mendes10z/ECA_Project/ACE_Project/TRABALHO_02/RELATORIO_ACE.pdf

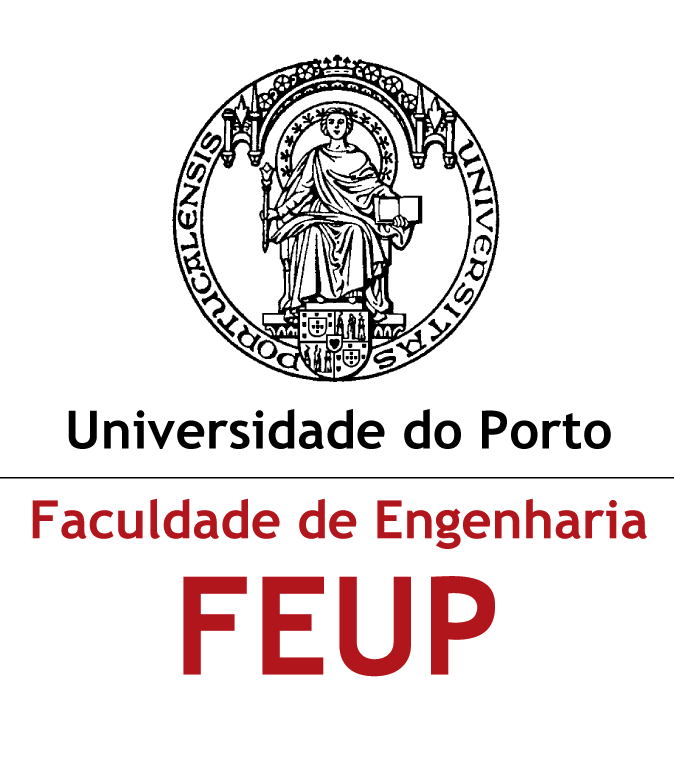
[picture p1: figure]

## "Robô Seguidor de Linha"

Rui Martins
up202104636

Ivo Mendes
up202108509

Relatório do Trabalho Prático realizado no âmbito da Unidade Curricular “Arquiteturas de Computação Embarcada”, do Mestrado em Engenharia Eletrotécnica e Computadores

Data de entrega: 30-01-2025

Declaramos que o presente trabalho/relatório é da nossa autoria e não foi utilizado previamente noutro curso ou unidade curricular, desta ou de outra instituição. As referências a outros autores (afirmações, ideias, pensamentos) respeitam escrupulosamente as regras da atribuição, e encontram-se devidamente indicadas no texto e nas referências bibliográficas, de acordo com as normas de referenciação. Temos consciência de que a prática de plágio e autoplágio constitui um ilícito académico.

In "Código Ético de Conduta Académica", art.14, Universidade do Porto.

## 1 Sumário

Este projeto envolveu o design, desenvolvimento e otimização de um robô capaz de seguir linhas e resolver labirintos (em forma de grelha) equipado com um Raspberry Pi Pico, múltiplos sensores e dois motores. Foram usadas técnicas de ajuste dinâmico de velocidade, controlo PID, calibração de sensores e mecanismos de desvio de obstáculos com o intuito de obter uma navegação mais precisa em trajetos complexos e irregulares de forma eficaz e autónoma.

## Índice

1 Sumário | 1
2 Introdução | 2
3 Hardware | 3
4 Pista | 4
5 Labirinto | 10
6 Desafios e Soluções | 18
7 Melhorias Futuras | 18
8 Conclusão | 18

## 2 Introdução

A robótica representa um dos pilares da engenharia moderna, combinando hardware e software para resolver problemas complexos. Neste contexto, o presente trabalho teve como objetivo desenvolver um robô capaz de seguir uma linha preta, de percorrer labirintos estruturados em grelha, desviar de obstáculos e ajustar dinamicamente a sua velocidade e trajetória. Utilizando um Raspberry Pi Pico como microcontrolador, o sistema integra cinco sensores infravermelhos para deteção de linha, um sensor ToF (Time-of-Flight) para evitar colisões e um controlador PID para correção de erros.
A implementação de algoritmos como o Breadth-First Search (BFS) permitiu ao robô calcular o caminho mais curto em labirintos, enquanto técnicas de otimização de hardware, como o uso de multiplexadores, garantiram alguma eficiência no processamento. Este relatório detalha não apenas as escolhas de design e os desafios técnicos enfrentados, mas também demonstra como a interação entre software e hardware foi crucial para superar limitações práticas, como atrasos de leitura de sensores e falhas inesperadas em componentes.
A abordagem adotada seguiu uma metodologia iterativa, onde cada etapa de desenvolvimento foi validada através de testes empíricos.

## 3 Hardware

### 3.1 Componentes Usados

1. Microcontrolador: Raspberry Pi Pico.
2. Motores: Dois motores DC.

### 3. Sensores:

- 5 sensores infravermelho (IR) para deteção da linha.
- Sensor de distância VL53L0X Time-of-Flight (ToF) para deteção de obstáculos.
4. Multiplexador: CD74HC4067 para expansão das entradas analógicas.
5. Driver de motor: Dual H-Bridge para controlo da direção e velocidade dos motores.
6. Fonte de Alimentação: Pack de baterias externo.

### 3.2 Design do Circuito

O hardware do robô foi conectado da seguinte forma:

- Sensores IR: Conectados ao multiplexador, que os liga a uma das entradas analógicas do Raspberry Pi Pico.
- Motores: Controlados pelo driver de motor utilizando sinais PWM.
- Sensor ToF: Comunica-se via protocolo I2C.

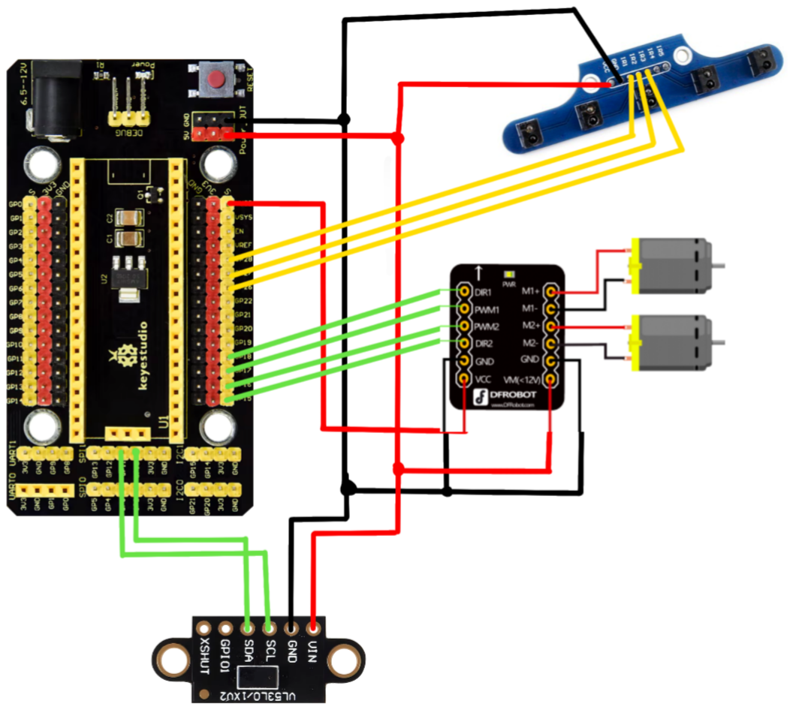
[picture p2: figure]

Figure 1: Conexões entre os componentes

## 4 Pista

### 4.1 Funcionalidades Principais

### 4.1.1 Deteção de linha

A primeira funcionalidade a merecer destaque é a deteção de linha. Como indicado no enunciado, o robô tem de ser capaz de identificar e guiar-se segundo uma linha preta num fundo branco, como ilustrado na Figura 2. Para tal, fazemos uso dos cinco sensores IR, bem como, de um método capaz de converter as leituras dos sensores em valores de erro passíveis de serem usados pelo controlador PID.

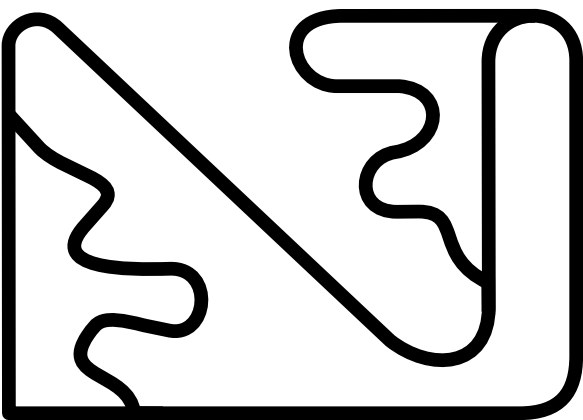
[picture p3: figure]

Figure 2: Mapa da pista.

Os sensores IR utilizados são capazes de registar valores num intervalo de 0 a 1023 e, sabendo que valores próximos de zero são zonas escuras e valores próximos de 1023 são zonas claras, somos capazes, através de um valor pré-definido de THRESHOLD, identificar quais sensores estão sobre a linha. Para além disso, o robô é capaz de recalibrar os valores máximo e mínimo de leitura registados de forma a adaptar-se a diferentes intensidade de cor de linha, por exemplo, o que permite uma normaliza mais precisa dos valores registados.

1 | void readLineSensors () {
2 | // Loop
3 | for (int i = 0; i < NUM_SENSORS ; i ++) {
4 | // Set the multiplexer to the current channel
5 | digitalWrite ( MUX_S1 , i & 0 x01 ) ; | // Bit 0
6 | digitalWrite ( MUX_S2 , ( i >> 1) & 0 x01 ) ; // Bit 1
7 | digitalWrite ( MUX_S3 , ( i >> 2) & 0 x01 ) ; // Bit 2
8 | digitalWrite ( MUX_S4 , ( i >> 3) & 0 x01 ) ; // Bit 3

9
10 | delayMicroseconds (50) ; // Allow time for the signal to stabilize

11
12 | // Read the sensor value
13 | sensorValues [ i ] = analogRead ( MUX_SIGNAL ) ;

14
15 | // Recalibrate sensor values
16 | if( sensorValues [ i ] > sensorMaxValue ) sensorMaxValue = sensorValues [ i
| ];
17 | else if( sensorValues [ i ] < sensorMinValue ) sensorMinValue =
| sensorValues [ i ];
18 | }

19
20 // (...) THRESHOLD logic for line detection

// Save last sensor values
for (int i = 0; i < NUM_SENSORS ; i ++)

{
lastSensorValues [ i ] = sensorValues [ i ];

}

}

As leituras dos sensores são guardadas num vetor sensorValues[5] de tamanho cinco. Estes valores são, posteriormente, utilizados num método calculateMediumSensor(), como visto a seguir, que faz uso da média ponderada dos mesmos de forma a obter a posição da linha em relação aos cinco sensores.

float calculateMediumSensor () {
float weightedSum = 0;
float totalInvertedValues = 0;

for (int i = 0; i < NUM_SENSORS ; i ++) {
6 | float invertedValue = sensorMaxValue - sensorValues [ i ]; | // Black
| gets a higher value than white
| // Weighted sum and total inverted values
| weightedSum += invertedValue * sensorWeights [ i ];
| totalInvertedValues += invertedValue ;

}

| if ( totalInvertedValues == 0) {
return round (( float ) NUM_SENSORS /2) ; // Default to center position if
| no line is detected

}

return ( weightedSum / totalInvertedValues ) + round (( float ) NUM_SENSORS
| /2) ; // Average + Offsets posLine to the real position

}

### 4.1.2 Implementação do Controlador PID

Um controlador PID (Proporcional-Integral-Derivativo) é um mecanismo de controlo por retroação amplamente utilizado em sistemas de controlo automático para ajustar variáveis de processo, como velocidade ou posição. O seu objetivo é minimizar o erro entre um valor desejado (setpoint) e o valor medido da variável controlada, através da combinação de três ações distintas:

### 1. Controlo Proporcional (P):

Esta componente gera uma correção proporcional ao erro atual (e(t)). Permite reduzir o erro rapidamente, no entanto, pode provocar erro residual em regime permanente ou oscilações.

P = Kpe(t)

### 2. Controlo Integral (I):

Esta componente elimina o erro residual acumulado ao longo do tempo, integrando o erro passado. Tem como finalidade a remoção de desvios persistentes, mas pode introduzir oscilações caso seja mal dimensionado
I = Ki

Z
e(t)dt

3. Controlo Derivativo (D): Esta terceira componente antecipa futuros erros com base na taxa de variação do erro de(t)
dt . Amortece oscilações e melhora a estabilidade, mas é extremamente sensível a ruído existente no sistema.
D = Kd

de(t)
dt

A soma das três componentes define a saída do controlador:

Saida = Kpe(t) +Ki

Z
e(t)dt +Kd

de(t)
dt

É através do valor posLine, e de um valor pré-definido setpoint de valor 3.0, que calculamos o erro a ser utilizado pelo controlador PID. Foram testados diversos valores para os coeficientes tendo chegado aos seguintes:

- Coeficiente de proporcionalidade: Kp = 1.4;
- Coeficiente de integração: Ki = 0.025;
- Coeficiente de derivação: Kd = 0.025.

Juntamente com o controlo PID implementámos um método de controlo dinâmico de velocidade que alimenta diretamente o controlador. Este método é responsável pela deteção de curvas ou de retas, diminuindo ou aumentando a velocidade, respetivamente.

void calculatePWMAndDir ( float posLine ) {
// Compute error
float error = posLine - setpoint ;

// Compute time difference for integral and derivative
unsigned long now = micros () ;
float dt = ( lastTime == 0) ? 0.02 : ( now - lastTime ) / 1000000.0; // Default to 20 ms if lastTime =0
lastTime = now ;

// Calculate integral (sum of errors over time ) integral += error * dt ;

// Calculate derivative ( rate of change of error ) float derivative = ( error - lastError ) / dt ;

// Adjust motor speed dynamically based on error
float dynamicSpeed = MOTOR_SPEED ;
if ( abs ( error ) < 0.5) {
dynamicSpeed = MOTOR_SPEED * map ( abs ( error ) , 0.0 , 0.5 , 1.0 + pastError , 1.0) ;
} else if ( abs ( error ) > 0.5) {
dynamicSpeed = MOTOR_SPEED * 0.8;

}

// PID
float correction = ( Kp * dynamicSpeed ) * error + ( Ki * dynamicSpeed ) * integral + ( Kd * dynamicSpeed ) * derivative ;

// Store the current error as the last error for the next iteration

28 lastError = error ;

29
30 | // Adjust motor speeds based on correction
31 | if ( error > 0 + COMPENSATION ) {
32 | if ( correction >= dynamicSpeed ) {
33 | motorDir [ MOTOR1 ] = REVERSE ;
34 | correction -= dynamicSpeed ;
35 | } else {
36 | motorDir [ MOTOR1 ] = FORWARD ;
37 | }
38 | motorSpeed [ MOTOR1 ] = abs ( round ( correction ) ) ;
39 | motorSpeed [ MOTOR2 ] = dynamicSpeed ;
40 | motorDir [ MOTOR2 ] = FORWARD ;

41
42 | // Decrease dynamic speed coefficient
43 | pastError -= 0.1;
44 | } else if ( error < 0 - COMPENSATION ) {
45 | if ( correction <= - dynamicSpeed ) {
46 | motorDir [ MOTOR2 ] = REVERSE ;
47 | correction += dynamicSpeed ;
48 | } else {
49 | motorDir [ MOTOR2 ] = FORWARD ;
50 | }
51 | motorSpeed [ MOTOR2 ] = abs ( round ( correction ) ) ;
52 | motorSpeed [ MOTOR1 ] = dynamicSpeed ;
53 | motorDir [ MOTOR1 ] = FORWARD ;

54
55 | // Decrease dynamic speed coefficient
56 | pastError -= 0.1;
57 | } else {
58 | motorDir [ MOTOR1 ] = motorDir [ MOTOR2 ] = FORWARD ;
59 | motorSpeed [ MOTOR1 ] = motorSpeed [ MOTOR2 ] = dynamicSpeed ;

60
61 | // Increase dynamic speed coefficient
62 | pastError += 0.1;
63 | }

64
65 | // Ensure motor speeds are within valid range
66 | motorSpeed [ MOTOR1 ] = constrain ( motorSpeed [ MOTOR1 ] , 0 , 255) ;
67 | motorSpeed [ MOTOR2 ] = constrain ( motorSpeed [ MOTOR2 ] , 0 , 255) ;
68 | pastError = constrain ( pastError , 0 , 1.5) ;
69 | }

Deve ser, também, mencionada a capacidade do algoritmo ajustar a direção dos motores de acordo com o erro obtido. Considerando o facto do robô ter cinco sensores e o sensor do meio (sensor três) ser o sensor de referência, facilmente chegamos à conclusão que o erro, para o nosso caso, poderá assumir valores no intervalo de [-2 ; 2]. Subdividindo o intervalo do erro em quatro setores de amplitude igual a um obtemos:

- Extremo esquerdo: erro ∈ [−2;−1];
- Centro esquerdo: erro ∈ [−1;0];
- Centro direito: erro ∈ [0;1];
- Extremo direito: erro ∈ [1;2];

Assim, e fazendo uso desta informação, sempre que o erro se encontre nos setores extremo, curva acentuada, o motor que se encontre mais próximo da linha deve girar em sentido oposto de forma a rapidamente corrigir o sistema (direção do robô).

### 4.1.3 Deteção de Obstáculos

A deteção de obstáculos é feita com recurso às distâncias medidas e registadas pelo sensor VL53L0X e pelo método ostacleAvoidance(). Aquando da deteção de um objeto, o robô entra num novo estado caracterizado por um comportamento de rotina, ou seja, o mesmo não faz uso de informações registadas pelos sensores para se deslocar e percecionar o meio que o rodeia. Segue apenas um caminho pré-definido.
Este novo estado faz uso de uma máquina de estados com o intuito de percorrer todas as funcionalidades pretendidas de forma sequencial.
1 | void obstacleAvoidance ( unsigned long currentMillis ) {
2 | switch ( obstacleState )
3 | {
4 | case ALIGN :
5 | // Aligns the robot to get a precise 90 degree rotation
6 | if ( alignRobot () )
7 | {
8 | obstacleState = STOP ;
9 | obstacleTimer = currentMillis ;
10 | }
11 | break ;

12
13 | case STOP :
14 | // Stops de robot
15 | motorSpeed [ MOTOR1 ] = 0;
16 | motorSpeed [ MOTOR2 ] = 0;
17 | if ( currentMillis - obstacleTimer >= 500) {
18 | obstacleState = RIGHT ;
19 | obstacleTimer = currentMillis ;
20 | }
21 | break ;

22
23 | case RIGHT :
24 | // Turns 90 degrees to the right
25 | if (! turning ) {
26 | turning | = true ;
27 | targetEncPosition = encPosition - TICKS_TURN_90 ;
28 | }

29
30 | if ( encPosition <= targetEncPosition ) {
31 | turning = false ;
32 | motorSpeed [ MOTOR1 ] = 0;
33 | motorSpeed [ MOTOR2 ] = 0;

34
35 | obstacleState = FRONT ;
36 | obstacleTimer = currentMillis ;
37 | }
38 | else {
39 | motorSpeed [ MOTOR1 ] = MOTOR_SPEED /2;
40 | motorDir [ MOTOR1 ] | = REVERSE ;

41
42 | motorSpeed [ MOTOR2 ] = MOTOR_SPEED /2;
43 | motorDir [ MOTOR2 ] | = FORWARD ;
44 | }
45 | break ;

47 | case FRONT :
48 | // Performs an half circle movement
49 | if (! turning ) {
50 | turning | = true ;
51 | targetEncPosition = encPosition + 7800;
52 | }

53
54 | if ( encPosition >= targetEncPosition ) {
55 | turning = false ;

56
57 | obstacleState = END ;
58 | obstacleTimer = currentMillis ;
59 | }
60 | else {
61 | motorSpeed [ MOTOR1 ] = MOTOR_SPEED ;
62 | motorDir [ MOTOR1 ] | = FORWARD ;

63
64 | motorSpeed [ MOTOR2 ] = MOTOR_SPEED /2;
65 | motorDir [ MOTOR2 ] | = FORWARD ;
66 | }
67 | break ;

68
69 | case END :
70 | // Readjusts the robot before returning to the normal control
| state
71 | readLineSensors () ;
72 | if ( currentMillis - obstacleTimer >= 1000) {
73 | start = true ;
74 | obstacleState = STOP ;
75 | } else {
76 | motorSpeed [ MOTOR1 ] = MOTOR_SPEED /2;
77 | motorDir [ MOTOR1 ] | = REVERSE ;

78
79 | motorSpeed [ MOTOR2 ] = MOTOR_SPEED /2;
80 | motorDir [ MOTOR2 ] | = FORWARD ;
81 | }
82 | break ;
83 | }
84 | }

NOTA: O sensor VL53L0X nem sempre deteta distâncias corretamente podendo levar à inicialização do processo de desvio de obstáculos de forma incorreta. Com o objetivo de corrigir o problema é usada uma variável que verifica se as últimas leituras por parte do sensor apresentam valores decrescentes entre si ou se ocorreu apenas um valor de pico.

## 5 Labirinto

### 5.1 Funcionalidade Principais

### 5.1.1 Deteção do caminho mais curto - Algoritmo BFS

O labirinto proposto é composto por uma grelha retangular com seis filas e cinco colunas, como ilustra a Figura 3. Tirando partindo desta informação, formulámos um algoritmo capaz de detetar o caminho mais rápido entre um ponto inicial (atual localização do robô) e o ponto final do labirinto. Baseámo-nos no método Breadth-First Search (BFS) para resolver o algoritmo em causa. Este método é um algoritmo de procura em árvore, como ilustrado na Figura 4, que explora todos os vértices da mesma através de uma abordagem em camadas. Tipicamente este tipo de algoritmos recorre a filas para garantir que os nós mais próximos do ponto inicial são explorados primeiro, no entanto, encontrámos alguma dificuldade na implementação e uso de filas e, portanto, recorremos a vetores, o que nos obrigou a fazer alguns ajustes ao algoritmo original.

Figure 3: Mapa do labirinto.

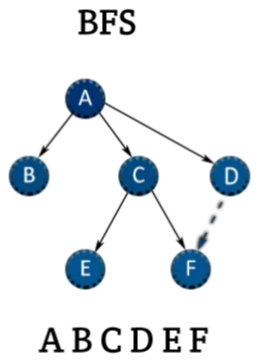
[picture p4: figure]

Figure 4: Algoritmo BFS e seu funcionamento.

Estruturalmente, recorremos a cinco métodos separados para implementar o algoritmo na sua totalidade. Esta abrodagem permite-nos tornar o código modular, versátil e receptivo a atualizações futuras se tal se mostrar necessário.
Os três primeiros métodos formulados, e como referido anteriormente, são responsáveis por modificar o vetor queue e recriar o comportamento típico e único das filas. São eles: clearQueue(); enqueue(); dequeue().
1 | void clearQueue () {
2 | queueFront = 0;
3 | queueBack | = 0;
4 | queueCount = 0;
5 | }

6
7 | bool enqueue (int rr , int cc ) {
8 | // If the queue is full , return false
9 | if ( queueCount >= MAX_QUEUE ) {
10 | return false ;
11 | }
12 | // Place the cell in queueArray at ’queueBack ’
13 | queueArray [ queueBack ]. r = rr ;
14 | queueArray [ queueBack ]. c = cc ;
15 | // Advance ’queueBack ’ in a circular way
16 | queueBack = ( queueBack + 1) % MAX_QUEUE ;
17 | // Increment the count
18 | queueCount ++;
19 | return true ;
20 | }

21
22 | bool dequeue (int * outR , int * outC ) {
23 | if ( queueCount <= 0) {
24 | // Queue is empty
25 | return false ;
26 | }
27 | // The front cell
28 | * outR = queueArray [ queueFront ]. r ;
29 | * outC = queueArray [ queueFront ]. c ;
30 | // Advance front index
31 | queueFront = ( queueFront + 1) % MAX_QUEUE ;
32 | queueCount - -;
33 | return true ;
34 | }

O quarto método é responsável por executar a lógica proposta pelo método BFS. Este método percorre o labirinto, representado pelo vetor mazeGrid[6][5], verificando quais interseções já foram visitadas, quais estão obstruídas e possíveis caminhos para alcançar o ponto final do labirinto, retornando true caso haja um trajeto possível. O vetor mazeGrid é um vetor do tipo binário registando valores true para interseções livres e false para interseções obstruídas. O vetor visited[6][5] regista as interseções já visitadas pelo robô.

1 | bool bfsComputePath (int startR , int startC , int goalR , int goalC ) {
2 | // Reset visited + parent arrays
3 | for (int r = 0; r < ROWS ; r ++) {
4 | for (int c = 0; c < COLUMNS ; c ++) {
5 | visited [ r ][ c ] | = false ;
6 | parentRow [ r ][ c ] | = -1;
7 | parentCol [ r ][ c ] | = -1;
8 | }
9 | }

10
11 clearQueue () ;

visited [ startR ][ startC ] = true ; enqueue ( startR , startC ) ;

// BFS loop
while ( queueCount > 0) {
int r , c ;
if (! dequeue (& r , & c ) ) { break ;

}

// If at the end of maze
if ( r == goalR && c == goalC ) { return true ;

}

// Check the 4 possible directions for (int i = 0; i < 4; i ++) {
int nr = r + directions [ i ][0]; int nc = c + directions [ i ][1];

// Check bounds
if ( nr >= 0 && nr < ROWS && nc >= 0 && nc < COLUMNS ) { // If the cell is free and not visited
if ( mazeGrid [ nr ][ nc ] && ! visited [ nr ][ nc ]) {
visited [ nr ][ nc ] = true ;
parentRow [ nr ][ nc ] = r ;
parentCol [ nr ][ nc ] = c ;
enqueue ( nr , nc ) ;

}

}

}

}

// If we exit the loop without finding the goal there is no path return false ;

}

Como é visível na função anteriormente apresentada, existem dois vetores (parent) responsáveis por armazenar as interseções que antecederam a movimentação do robô pelo labirinto. Apesar de não serem utilizados diretamente e exclusivamente para esse propósito, por questões de praticidade, permitemnos recriar o trajeto percorrido pelo robô. Na eventualidade de ser requerido que o robot retornarsse à posição inicial poderíamos recorrer a estes vetores, possibilitando uma implementação mais rápida e eficaz. Esta funcionalidade pretende demonstrar, novamente, o nosso comprometimento com a modularidade do código.
A quinta, e última função, possibilita-nos reconstruir o trajeto anteriormente encontrado. Após ser detetado a existência de, pelo menos, um possível trajeto, o mesmo é reconstruído e armazenado na variável path.

void reconstructPath (int startR , int startC , int goalR , int goalC ) { pathLength = 0;

// If the goal wasn ’t visited , no path
if (! visited [ goalR ][ goalC ]) {
return ;

}

// We ’ll store the path in reverse order first in a temporary buffer

// ( goal -> start ), then we ’ll flip it. int tempRow [ MAX_PATH ];
int tempCol [ MAX_PATH ];
int count = 0;

// Start from goal
int r = goalR ;
int c = goalC ;

while (!( r == startR && c == startC ) ) { tempRow [ count ] = r ;
tempCol [ count ] = c ;
count ++;

// Jump to the parent cell int pr = parentRow [ r ][ c ]; int pc = parentCol [ r ][ c ]; r = pr ;
c = pc ;

}
// Finally add the start node tempRow [ count ] = startR ; tempCol [ count ] = startC ;
count ++;

// Now ’count ’ is the number of cells in the path
// Reverse them into pathR [] , pathC [] to get start - > goal order pathLength = count ;
int idx = 0;
for (int i = count - 1; i >= 0; i - -) {
pathR [ idx ] = tempRow [ i ];
pathC [ idx ] = tempCol [ i ];
idx ++;

}

}

### 5.1.2 Deteção de Obstáculos

Para a deteção de obstáculos, usamos uma lógica em tudo semelhante à da pista. Verificamos se as duas últimas leituras têm relação entre si, ou seja, se são decrescentes e, caso estejam abaixo do limite indicado, a função detectObstacle() retorna true. A deteção de objetos desencadeia uma reconstrução do caminho previamente sugerido pelo algoritmo BFS.

bool detectObstacle () {
if ( ( prev_distance <= DIST_OBJECT * 2.5) && ( distance <= DIST_OBJECT * 1.5) ) {
return true ;

}
else return false ;

}

A Figura 5 representa o momento de deteção de um objeto tornando o caminho inviável.

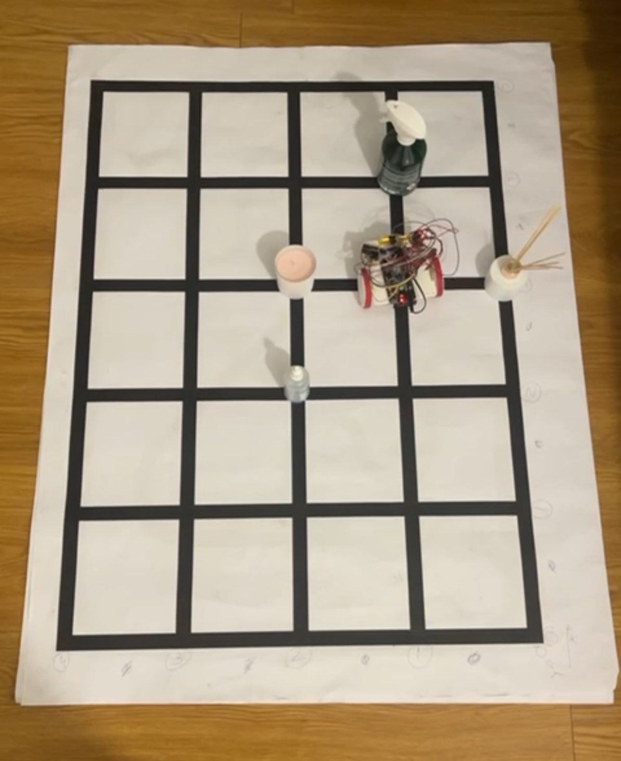
[picture p5: figure]

Figure 5: Obstáculo obstruindo o caminho.

### 5.1.3 Movimentação entre interseções

Após a descoberta do caminho mais curto até à posição final, é necessário deslocar o robô para a próximo interseção. Para tal temos de ter em consideração dois fatores:

- Direção atual e direção pretendida;
- Posição espacial no labirinto.

A direção atual (Norte, Sul, Este, Oeste) deve ser comparada com a direção pretendida para que o robô execute a rotação que permita alinhá-lo corretamente com o trajeto pretendido, ou seja, se o robô estiver voltado para Norte e a direção pretendida é Oeste, este deve girar noventa graus no sentido contrário aos ponteiros do relógio.
O método responsável por executar a rotação do robô é apresentado a seguir:
1 | bool turn90 (int side ) { // "0" to go right and "1" to go left
2 | switch ( side )
3 | {
4 | // Turn right
5 | case 0:{
6 | if (! turning ) {
7 | turning | = true ;
8 | targetEncPosition = encPosition - TICKS_TURN_90 ;

9
10 | motorSpeed [ MOTOR1 ] = MOTOR_SPEED /2;
11 | motorDir [ MOTOR1 ] | = REVERSE ;

12
13 | motorSpeed [ MOTOR2 ] = MOTOR_SPEED /2;
14 | motorDir [ MOTOR2 ] | = FORWARD ;

15
16 | motorControl () ;
17 | }

if ( encPosition <= targetEncPosition ) { turning = false ;
motorSpeed [ MOTOR1 ] = 0;
motorSpeed [ MOTOR2 ] = 0;

motorControl () ;

if( currDir == WEST ) currDir = NORTH ; else currDir ++;

return true ;

}
break ;

}

// Turn left
case 1:{
// (...) Same logic as the previous case but rotates to the other side
break ;

}

return false ;

}

Verificada a direção correta do robô e devida rotação, o mesmo deve deslocar-se até à próxima interseção. Para tal, recorremos aos valores dos sensores das extremidades (sensores 1 e 5) e, mais precisamente, ao flanco descente dos mesmos. Caso o sensor, no ciclo, passado tenha detetado um valor inferior ao da THRESHOLD e o valor atual seja superior ao da THRESHOLD, detetamos a interseção e procedemos a um ajuste de posição e consequente paragem, reiniciando o ciclo.
A movimentação do robô recorre a uma versão mais simples do algoritmo anteriormente apresentado com o controlador PID. Devido à baixa velocidade do robô durante esta prova, não se justifica o uso de um algoritmo tão preciso.
A função responsável pela movimentação do robô entre interseções é a seguinte:

bool goToNextIntersection (int speed ) {
// Read sensor values
readLineSensors () ;

if( intersection ) { // If intersection is detected switch ( currDir )

{
case NORTH :
currRow ++;
break ;

case SOUTH :
currRow - -;
break ;

case EAST :
currCol - -;
break ;

case WEST :
currCol ++;
break ;

23 | }

24
25 | motorDir [ MOTOR1 ] = motorDir [ MOTOR2 ] = FORWARD ;
26 | motorSpeed [ MOTOR1 ] = motorSpeed [ MOTOR2 ] = 0;
27 | motorControl () ;

28
29 | intersection = false ;
30 | atIntersection = false ;

31
32 | return false ;
33 | }
34 | else { // If intersection is not detected keep moving
35 | float posLine = mazeCalculateMediumSensor () ;

36
37 | // Calculate error
38 | float error = posLine - setpoint ;

39
40 | if ( error > 0 + COMPENSATION ) {
41 | motorSpeed [ MOTOR1 ] = 0;
42 | motorDir [ MOTOR1 ] = FORWARD ;

43
44 | motorSpeed [ MOTOR2 ] = speed ;
45 | motorDir [ MOTOR2 ] = FORWARD ;
46 | } else if ( error < 0 - COMPENSATION ) {
47 | motorSpeed [ MOTOR2 ] = 0;
48 | motorDir [ MOTOR2 ] = FORWARD ;

49
50 | motorSpeed [ MOTOR1 ] = speed ;
51 | motorDir [ MOTOR1 ] = FORWARD ;
52 | } else {
53 | motorDir [ MOTOR1 ] = motorDir [ MOTOR2 ] = FORWARD ;
54 | motorSpeed [ MOTOR1 ] = motorSpeed [ MOTOR2 ] = speed ;
55 | }

56
57 | motorControl () ;

58
59 | return true ;
60 | }
61 | }

Na Figura 6 podemos confirmar a movimentação anteriormente descrita após a deteção de obstáculos, ilustrada pela Figura 5.

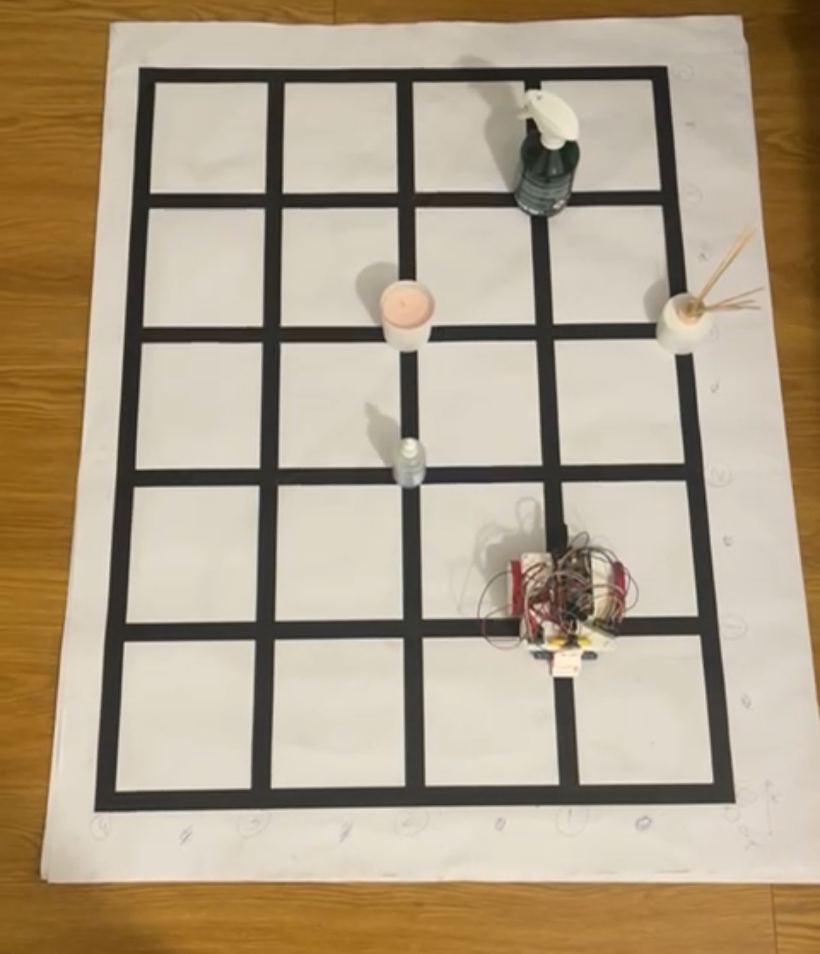
[picture p6: figure]

Figure 6: Inversão de marcha do robô após deteção de objetos.

### 5.2 Modo de Operação

Para resolver o labirinto, recorremos a uma máquina de estados composta por nove estados. Os mesmo encontrados enumerados a seguir:

1 | enum {
2 | MAZE_STOP ,
3 | MAZE_EXECUTE_PATH ,
4 | MAZE_CALCULATE_SHORTEST_PATH ,
5 | MAZE_ALIGN_CAR ,
6 | MAZE_TURN_CAR ,
7 | MAZE_DETECT_OBSTACLE ,
8 | MAZE_MOVE_CAR ,
9 | MAZE_ADJUST_CAR ,
10 | MAZE_END
11 | };

O estado MAZE CALCULATE SHORTEST PATH é considerado o estado inicial e é responsável pela deteção do caminho mais curto explicada em detalhe no Capítulo 5.1.1. Cada um dos estados assume um papel fundamental para a correta execução do teste do labirinto.
Após a execução do algoritmo, o código avança para o estado MAZE EXECUTE PATH. Este estado marca o início da sequência de procedimentos para alcançar a próxima interseção/posição do caminho. A sequência começa pelo alinhamento do robô com a linha preta (estado MAZE ALIGN CAR), seguido pelo ajuste de rotação do robô se necessário (estado MAZE TURN CAR). Concluída a rotação, o robô deve detetar a existência de qualquer tipo de obstáculo (estado MAZE DETECT OBSTACLE) e se possível avançar (estado MAZE MOVE CAR). Na eventualidade de existir um obstáculo no caminho, a sequência retorna ao início. Após a movimentação do robô e deteção da interseção, o robô deve ser ajustado (estado MAZE ADJUST CAR)de forma a facilitar a execução da próxima iteração do ciclo. Antes de reiniciar o ciclo, o robô fica parado meio segundo (estado MAZE STOP).
Quando o robô deteta que chegou ao destino/ponto final o mesmo para e não executa mais nenhuma função (estado MAZE END).

## 6 Desafios e Soluções

O desenvolvimento do projeto enfrentou vários obstáculos técnicos que exigiram análise detalhada e ajustes iterativos. Um dos primeiros desafios surgiu com as leituras inconsistentes dos sensores, inicialmente atribuídas a interferências como variações de luminosidade. Para resolver este problema, implementou-se uma rotina de calibração automática executada a cada leitura de valores dos sensores. Para além disso, durante este processo, identificou-se que a função analogRead(), utilizada para leitura dos sensores, consumia recursos excessivos do microcontrolador criando alguns atrasados de execução. Paralelamente, ocorreram inconsistências na direção de um dos motores, que não invertia o sentido de rotação conforme programado. Após verificação, descobriu-se que o problema estava relacionado alguns pinos da motherboard do microcontrolador, que deixaram de responder sem causa aparente. Infelizmente não foi possível corrigir estas falhas.
O uso de um multiplexador para expandir a capacidade de leitura de sensores também introduziu certas complicações. Verificou-se que o componente causava atrasos significativos no ciclo de leitura de valores dos sensores. Para contornar este limite, otimizou-se o loop de leitura, dividindo as leituras por fases e introduzindo microatrasos de estabilização entre cada operação, o que melhorou significativamente a eficiência e precisão do código.
Por fim, após uma queda durante os testes na pista, um dos motores começou a apresentar um barulho estranho quando girava no sentido oposto. Não foi possível corrigir esta falha por falta de tempo.

## 7 Melhorias Futuras

Embora o sistema atual funcione dentro dos parâmetros estabelecidos, existem várias otimizações que poderiam aumentar a sua eficiência e desempenho em cenários mais exigentes. Uma das principais áreas de melhoria reside no método de leitura dos sensores. Atualmente, os cinco sensores são lidos em cada ciclo de loop, mesmo quando apenas um subconjunto deles é relevante para decisões imediatas (por exemplo, em retas longas). Uma abordagem mais inteligente permitiria ler apenas os sensores necessários para cada situação, reduzindo o tempo de processamento.
A velocidade do robô no labirinto também apresenta margem para melhoria. Embora a configuração atual priorize a estabilidade, a utilização de algoritmos mais capazes ou a implementação de um controlador PID permitiriam acelerar o movimento em zonas seguras, como retas, desacelerando apenas em curvas ou intersecções.
Seria interessante, também, concluir a implementação do retorno do robô para a posição inicial do labirinto. Parte do processo e da lógica já se encontram implementados.
Por fim, a implementação de uma interface Wifi/Bluetooth (visto que foi usada uma Raspberry Pi Pico com módulo de Wifi) para comunicação com o robô à distância.

## 8 Conclusão

O projeto permitiu concluir com êxito a construção e desenvolvimento de um robô autónomo capaz de descodificar labirintos e seguir linhas pretas com precisão. A utilização de um controlador PID ajustável em tempo real garantiu uma resposta fluida a variações na trajetória, enquanto o algoritmo BFS assegurou eficiência na resolução de labirintos, mesmo na presença de obstáculos imprevistos.
Os desafios técnicos, como a inconsistência nas leituras dos sensores e as falhas de pinos do microcontrolador, não foram totalmente superados, no entanto, o robô demonstrou robustez suficiente para operar em ambientes controlados.
Este trabalho evidenciou o potencial da combinação entre algoritmos clássicos de procura e controlo proporcional-integral-derivativo em aplicações de robótica móvel. Futuras melhorias, como a implementação de comunicação sem fios, poderiam elevar o sistema a novos patamares de desempenho.
