mendes10z/ECA_Project/ACE_Project/TRABALHO_02/CHASSIS/raft_bot_v4.stl

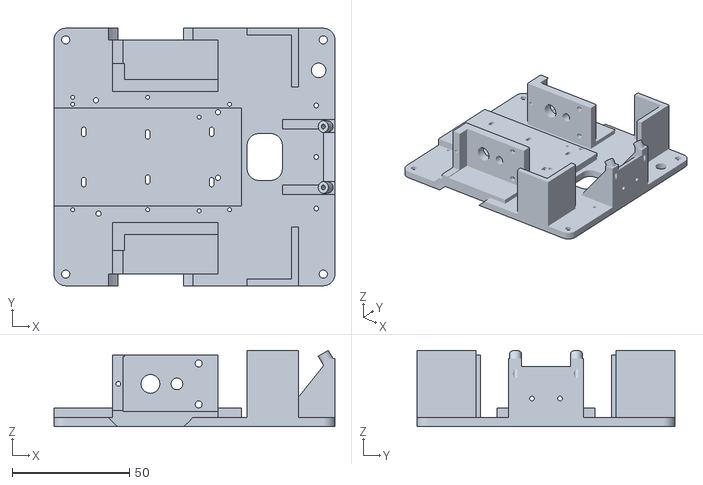
[picture p7: CAD file, 2026-03-28]
ACE_Project/TRABALHO_02/CHASSIS/raft_bot_v4.stl
120.0 x 110.0 x 32.6
